benmoran/robophone/3dprinting/ATTRIBUTION.md

Using continuous servo FS90R model by gk99 - www.thingiverse.com/3045553 (Creative Commons Attribution)
