benmoran/robophone/3dprinting/bottomchassis.stl

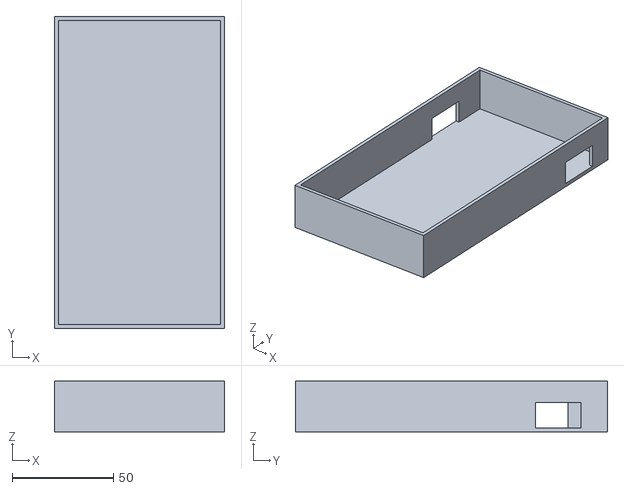
[picture p3: CAD file, 2020-06-10]
3dprinting/bottomchassis.stl
84.0 x 154.0 x 25.0
