benmoran/robophone/3dprinting/Continous_servo_FS90R_v4.stl

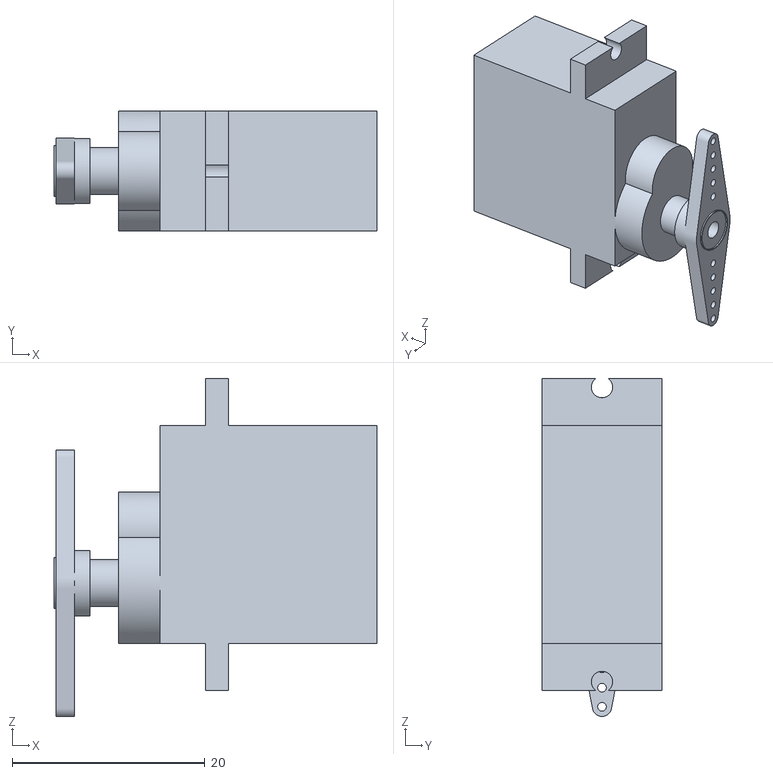
[picture p4: CAD file, 2020-06-10]
3dprinting/Continous_servo_FS90R_v4.stl
33.5 x 12.5 x 35.1
