benmoran/robophone/3dprinting/topchassis.stl

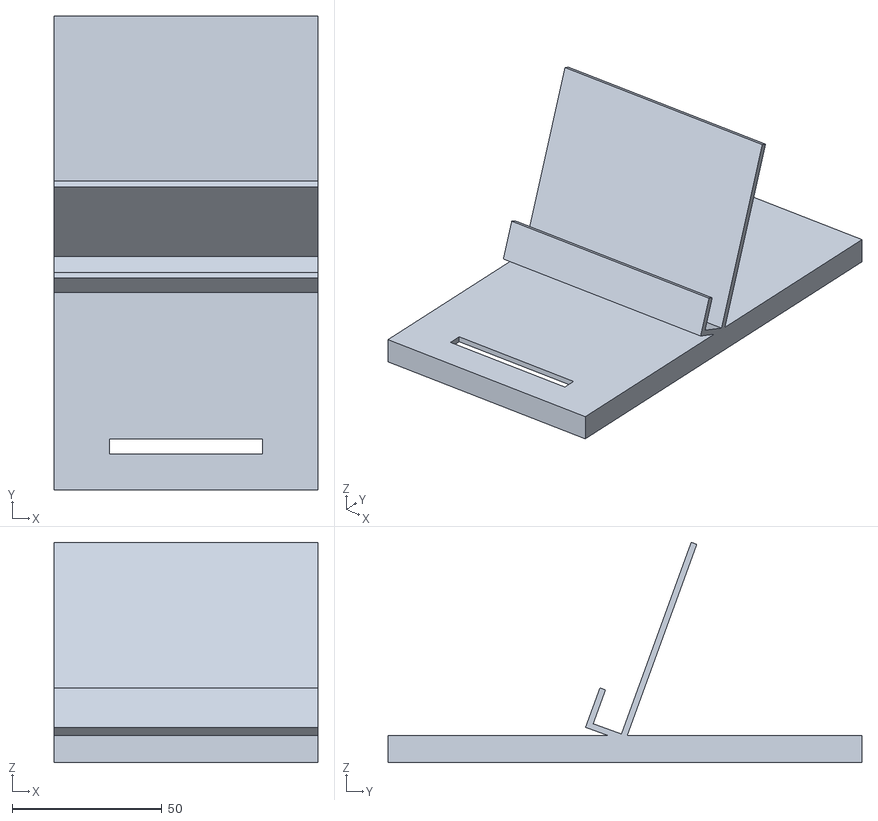
[picture p5: CAD file, 2020-06-10]
3dprinting/topchassis.stl
88.0 x 158.0 x 73.5
